GroznyiBombila/VichMashHW/README.md

# 4-битный сумматор на транзисторах 2N7000

Сумматор с последовательным переносом (ripple-carry) из 77 дискретных
полевых транзисторов, без единой микросхемы. Складывает два 4-битных числа
и входной перенос: A + B + Cin, результат от 0 до 31 горит на пяти светодиодах.

**[Схема в симуляторе Falstad](https://www.falstad.com/circuit/circuitjs.html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)**: открывается в браузере,
по переключателям можно щёлкать.

---

## Результаты работы

Папка работы: **[homework2](homework2/)**, фото: **[Results](homework2/Results/)**

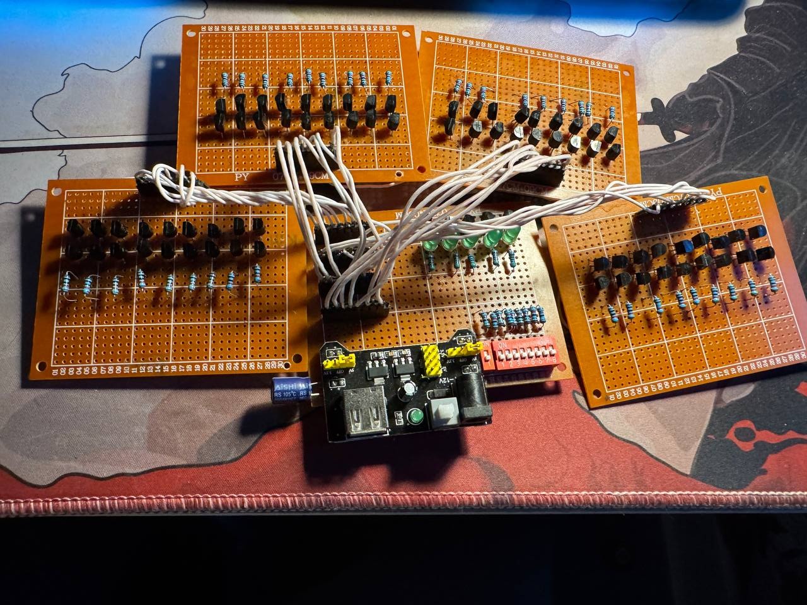
[picture p1: homework2/Results/device.jpg]
Устройство


Пять плат: четыре платы разряда (по одной на бит) и плата ввода-вывода с
переключателями и светодиодами. Питание 5 В от модуля MB102.

### Как читать

- Рычажки DIP-8 слева направо: B0 B1 B2 B3 A0 A1 A2 A3. Рычажок вверх (к ON) = 1.
- Отдельный красный DIP-1 слева = Cin.
- Светодиоды слева направо: Cout S3 S2 S1 S0, веса 16 8 4 2 1.

### Тесты

Разбор трёх тестов: какой рычажок за что отвечает и какие светодиоды горят.

<p>
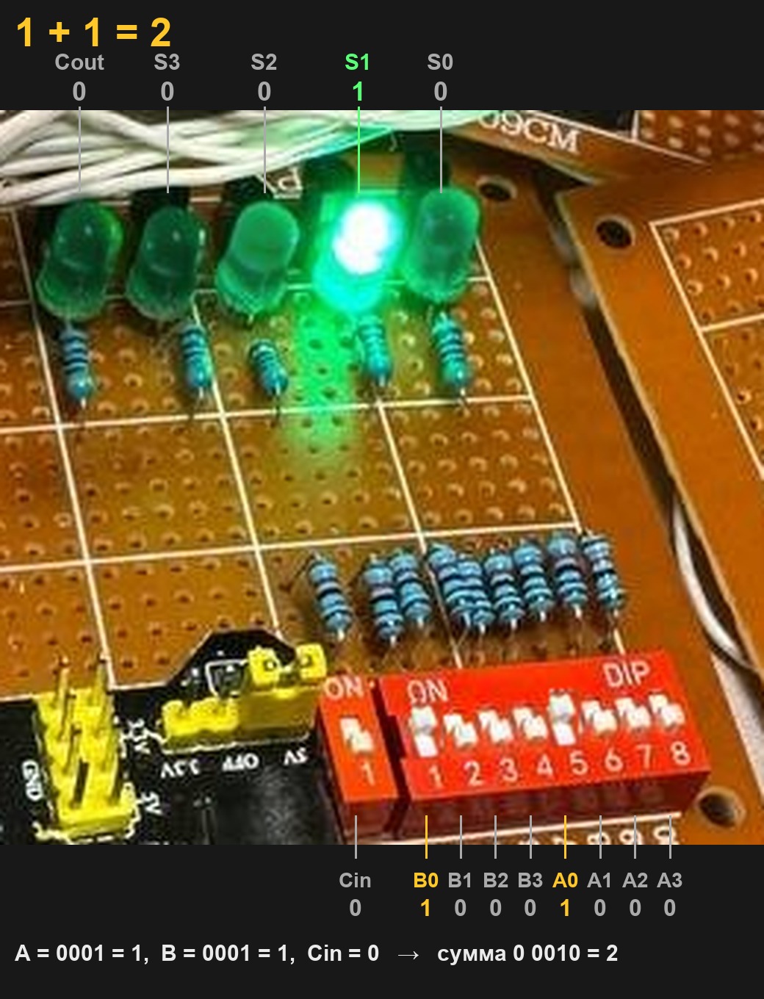
[picture p2: homework2/Results/test2_explained.jpg]
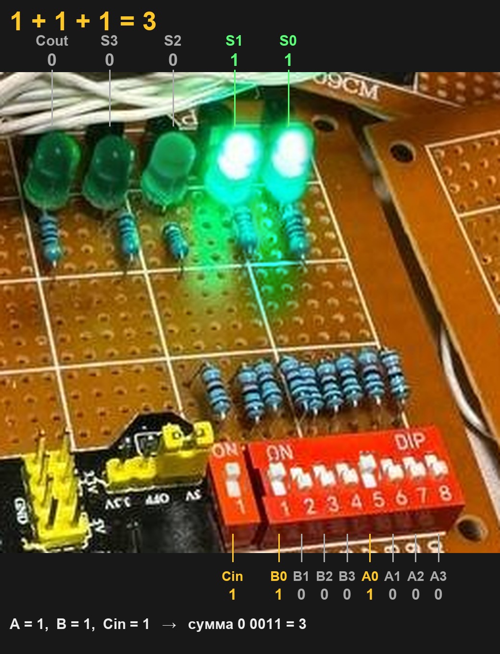
[picture p3: homework2/Results/test9_explained.jpg]
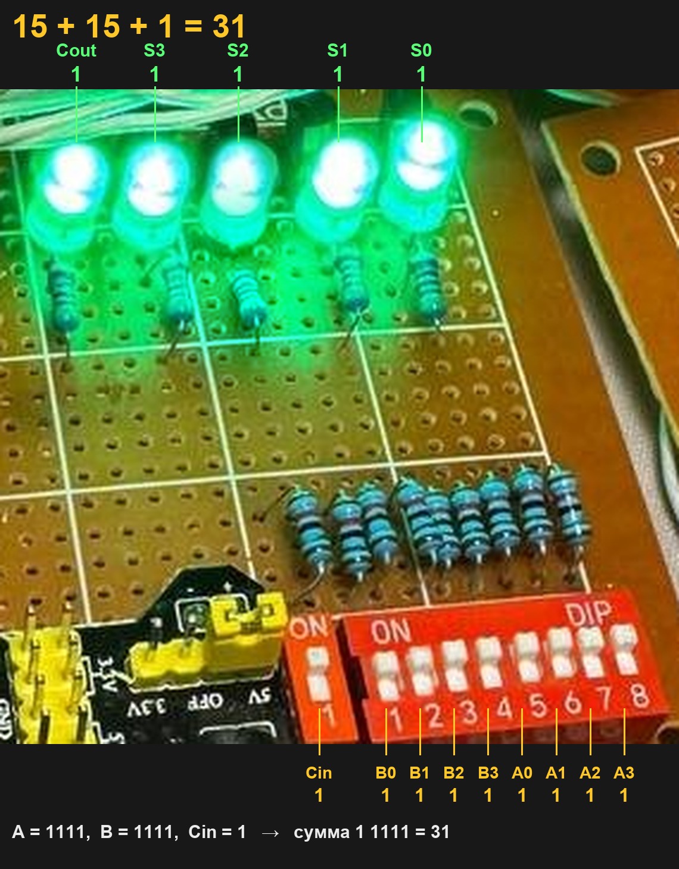
[picture p4: homework2/Results/test10_explained.jpg]
  
</p>

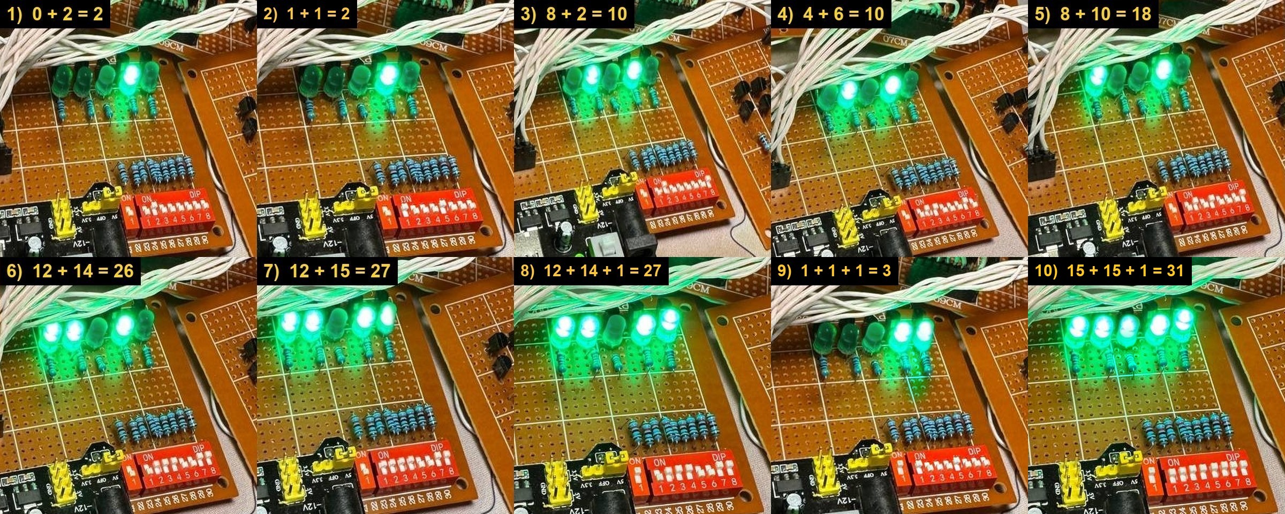
[picture p5: homework2/Results/tests.jpg]
Тесты


| № | A | B | Cin | сумма | светодиоды Cout S3 S2 S1 S0 | фото |
|---|---|---|---|---|---|---|
| 1 | 0000 (0) | 0010 (2) | 0 | 2 | 0 0010 | [test1](homework2/Results/test1.jpg) |
| 2 | 0001 (1) | 0001 (1) | 0 | 2 | 0 0010 | [test2](homework2/Results/test2.jpg), [крупно](homework2/Results/test2_close.jpg) |
| 3 | 1000 (8) | 0010 (2) | 0 | 10 | 0 1010 | [test3](homework2/Results/test3.jpg) |
| 4 | 0100 (4) | 0110 (6) | 0 | 10 | 0 1010 | [test4](homework2/Results/test4.jpg) |
| 5 | 1000 (8) | 1010 (10) | 0 | 18 | 1 0010 | [test5](homework2/Results/test5.jpg) |
| 6 | 1100 (12) | 1110 (14) | 0 | 26 | 1 1010 | [test6](homework2/Results/test6.jpg) |
| 7 | 1100 (12) | 1111 (15) | 0 | 27 | 1 1011 | [test7](homework2/Results/test7.jpg) |
| 8 | 1100 (12) | 1110 (14) | 1 | 27 | 1 1011 | [test8](homework2/Results/test8.jpg) |
| 9 | 0001 (1) | 0001 (1) | 1 | 3 | 0 0011 | [test9](homework2/Results/test9.jpg) |
| 10 | 1111 (15) | 1111 (15) | 1 | 31 | 1 1111 | [test10](homework2/Results/test10.jpg) |

- 1 + 1 = 2: в младшем разряде 1 + 1, сумма 0 и перенос в следующий разряд.
- 4 + 6 = 10: перенос из разряда 2 в разряд 3.
- 8 + 10 = 18: в старшем разряде 1 + 1, перенос уходит наружу и загорается Cout.
- Тесты 7 и 8 дают 27 двумя способами: единица в младшем разряде пришла
  от B0 или от входного переноса Cin.
- 1 + 1 + 1 = 3: в младшем разряде складываются все три входа, сумма 1 и перенос 1.
- 15 + 15 + 1 = 31: максимум, перенос проходит через все 4 разряда, горят все 5 светодиодов.

---

## Сборка и пайка

Все пять плат с компонентами, до соединения кабелями:

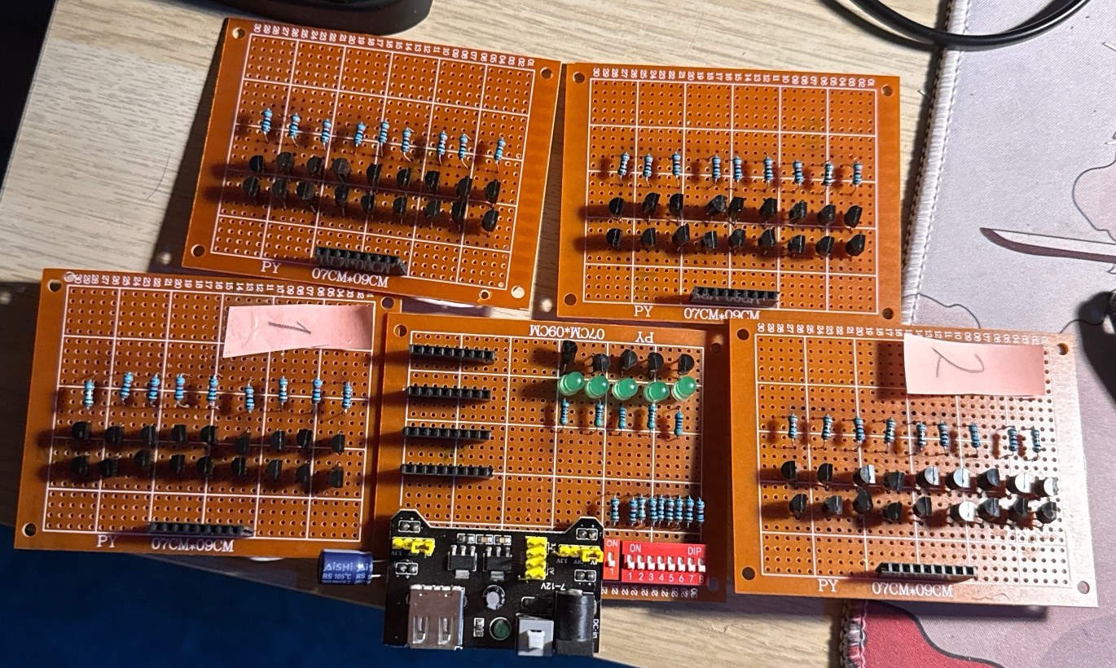
[picture p6: homework2/Results/assembly/boards_top.jpg]
Платы сверху


Плата ввода-вывода: сверху на этапе монтажа и снизу, готовая разводка.

<p>
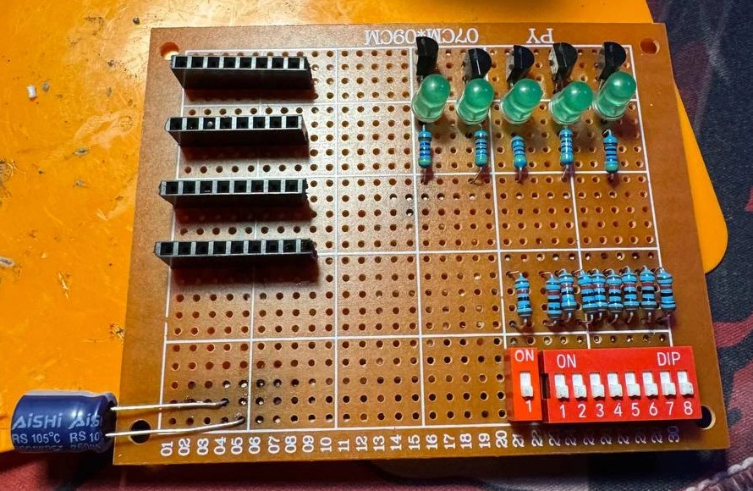
[picture p7: homework2/Results/assembly/io_board_top.jpg]
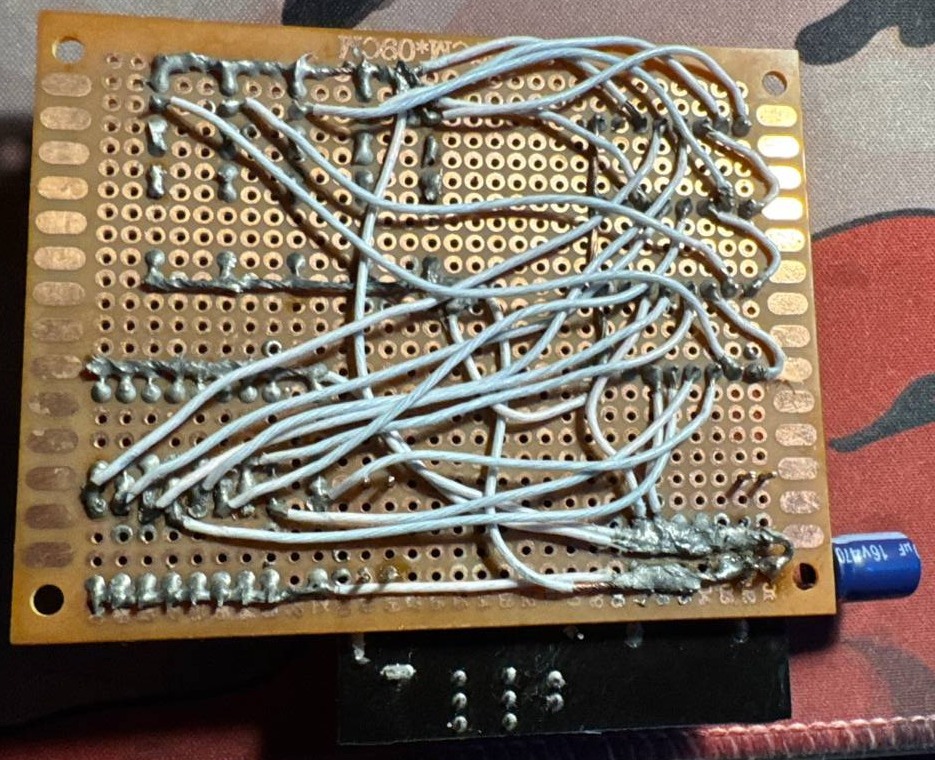
[picture p8: homework2/Results/assembly/io_board_bottom.jpg]
 
</p>

Плата разряда снизу: шина +5 В сверху, шина GND снизу, между ними перемычки
между ячейками и провода к разъёму.

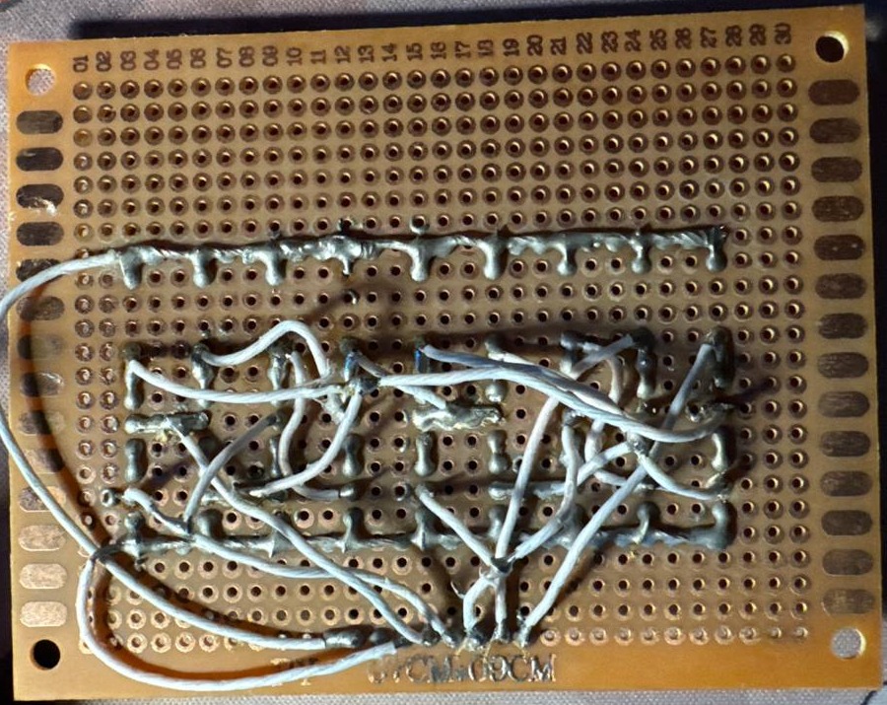
[picture p9: homework2/Results/assembly/bit_board_bottom.jpg]
Плата разряда снизу


Низ плат разряда и система в сборе, соединённая кабелями:

<p>
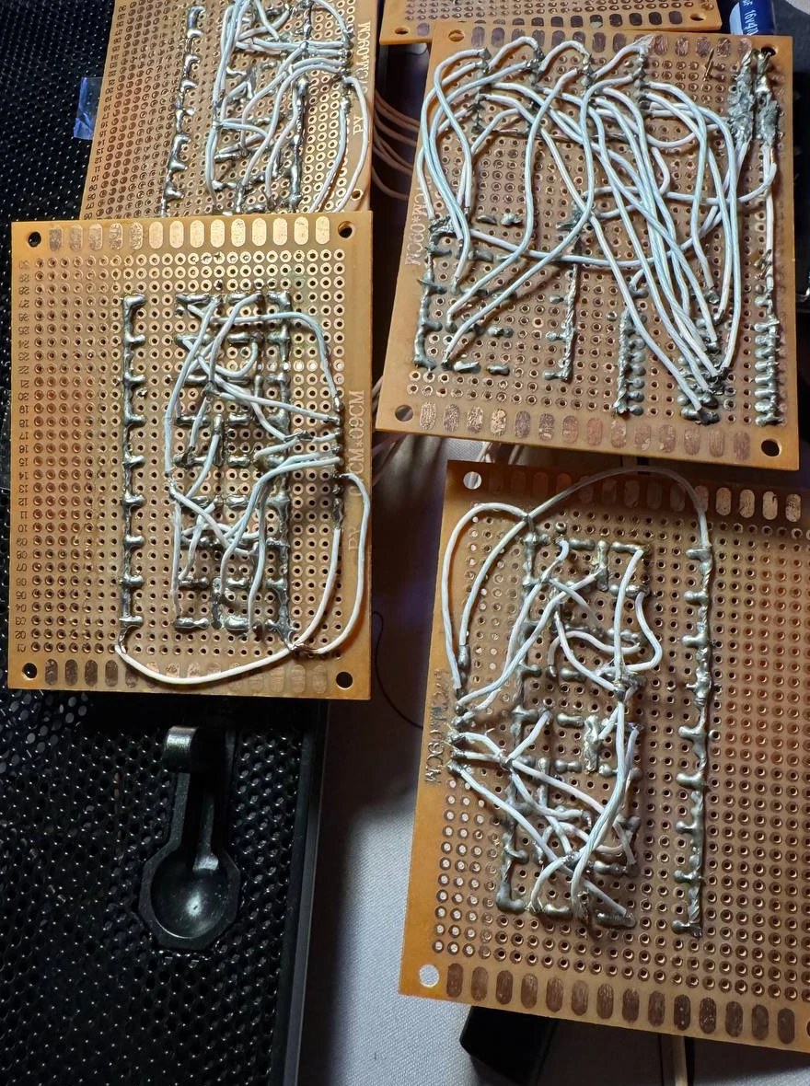
[picture p10: homework2/Results/assembly/boards_bottom.jpg]
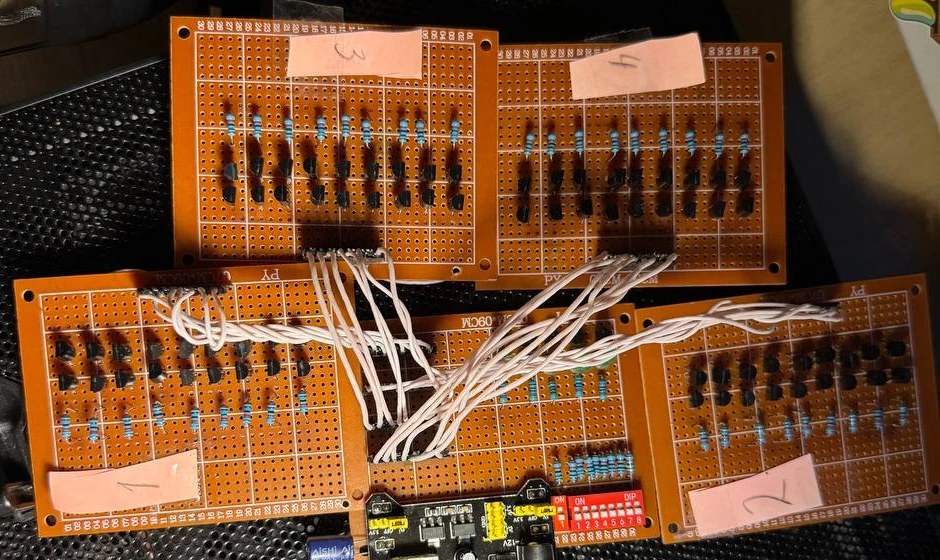
[picture p11: homework2/Results/assembly/system_wired.jpg]
 
</p>

---

## Как это работает

- **Вентиль И-НЕ**: два n-МОП транзистора последовательно и резистор 10 кОм к +5 В.
  Выход 0, только когда оба входа 1.
- **Полный сумматор** (один разряд): 9 вентилей И-НЕ, это 18 транзисторов и 9 резисторов.
  Складывает A, B, Cin и выдаёт сумму S и перенос Cout.
- **Перенос**: Cout разряда i идёт на Cin разряда i+1, как «1 в уме» при сложении
  столбиком. Перенос бежит от младшего разряда к старшему.

```
N1 = И-НЕ(A, B)      N4 = И-НЕ(N2, N3)  = A xor B
N2 = И-НЕ(A, N1)     N5 = И-НЕ(N4, Cin)
N3 = И-НЕ(B, N1)     N6 = И-НЕ(N4, N5)
                     N7 = И-НЕ(Cin, N5)
S    = И-НЕ(N6, N7)  = A xor B xor Cin
Cout = И-НЕ(N1, N5)  = A·B + Cin·(A xor B)
```

---

## Схемы

### Плата ввода-вывода и вся система

Рычажки через резисторы 10 кОм подают 0 или 5 В на входы, выходы разрядов
открывают транзисторы Q1–Q5, а те зажигают светодиоды. Четыре кабеля по
7 проводов идут к платам разряда.

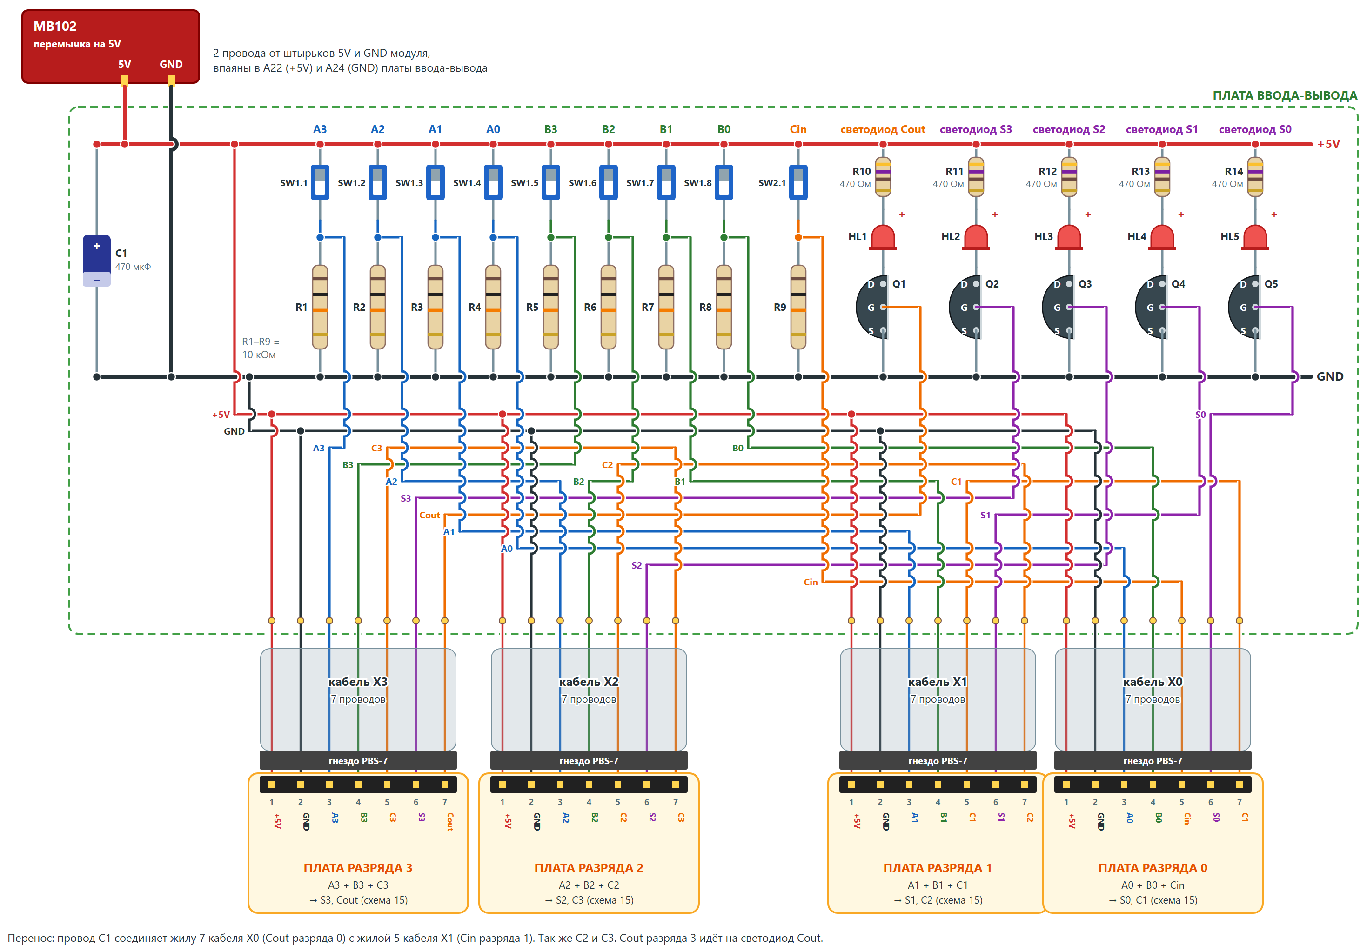
[picture p12: homework2/Results/io_board_and_system.png]
Плата ввода-вывода


### Плата разряда

Девять ячеек И-НЕ, разъём J1: +5V, GND, A, B, Cin, S, Cout.

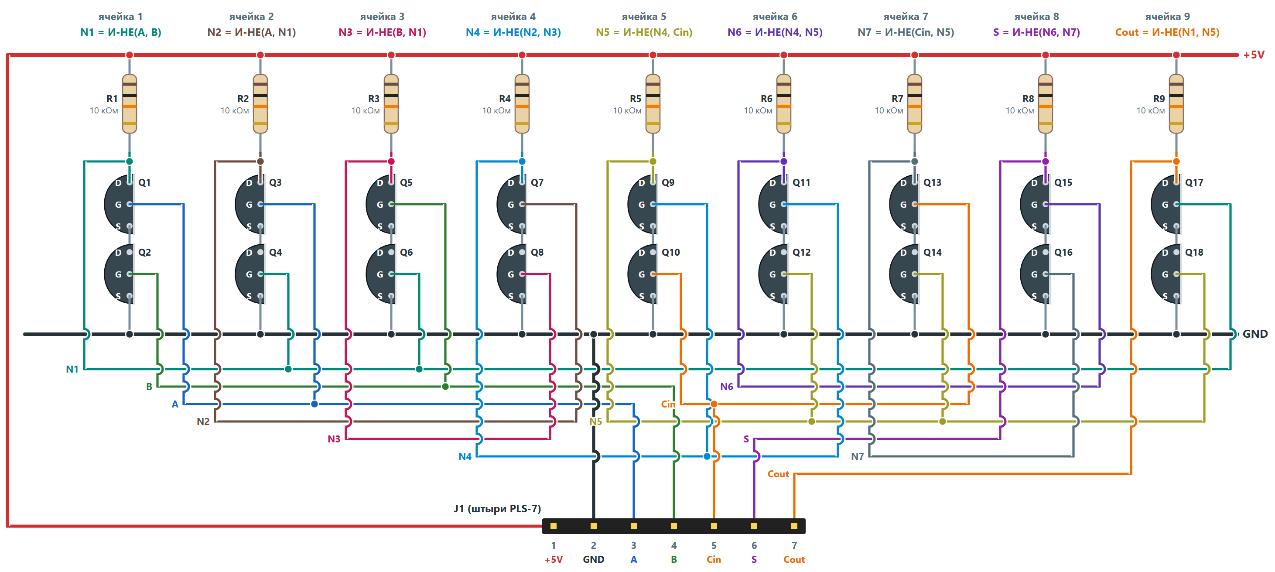
[picture p13: homework2/Results/bit_board.png]
Плата разряда


Остальные чертежи (расположение деталей по отверстиям, пайка снизу, цоколёвка):
[schematics/](homework2/schematics/), подробно в [assembly.md](homework2/assembly.md).

---

## Состав

| деталь | всего |
|---|---|
| транзистор 2N7000 | 77 (18 × 4 разряда + 5 на светодиоды) |
| резистор 10 кОм | 45 |
| резистор 470 Ом | 5 |
| светодиод 5 мм | 5 |
| DIP-переключатель на 8 и на 1 позицию | 1 + 1 |
| макетная плата 7×9 см | 5 |
| модуль питания MB102 | 1 |

```
homework2/Results/        фото устройства и основные схемы
schematics/     все чертежи (SVG)
sim/            схема для Falstad: ссылка и текст для импорта
tools/          генераторы чертежей и проверка раскладки на 512 комбинациях
assembly.md     сборка, проверка по шагам, таблица истинности разряда
wiring.md       список монтажа по отверстиям
```

---

## Как повторить

1. Открыть [схему в Falstad](https://www.falstad.com/circuit/circuitjs.html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) и проверить сложение в симуляторе.
   Тот же текст схемы лежит в [sim/adder4.txt](homework2/sim/adder4.txt) (Файл → Импорт из текста).
2. Собрать плату ввода-вывода и четыре платы разряда по [assembly.md](homework2/assembly.md)
   и [wiring.md](homework2/wiring.md).
3. Проверять разряды по одному, начиная с младшего, по таблице истинности из assembly.md.
