GroznyiBombila/VichMashHW/homework2/wiring.md

# Список монтажа

Сгенерировано скриптом `tools/boards.py` из тех же данных, что и чертежи, и проверено
моделированием всей собранной системы. Отверстие = буква ряда + номер столбца (вид сверху):
`F3` — ряд F, столбец 3. Отмечайте галочками по ходу пайки.

## Плата разряда (одинаковая для разрядов 0–3)

### Детали

- [ ] **R1** 10k: 1=A3, 2=E3
- [ ] **Q1** 2N7000: D=F3, G=G3, S=H3 (плоская сторона ВПРАВО, к столбцу 30; D сверху)
- [ ] **Q2** 2N7000: D=I3, G=J3, S=K3 (плоская сторона ВПРАВО, к столбцу 30; D сверху)
- [ ] **R2** 10k: 1=A6, 2=E6
- [ ] **Q3** 2N7000: D=F6, G=G6, S=H6 (плоская сторона ВПРАВО, к столбцу 30; D сверху)
- [ ] **Q4** 2N7000: D=I6, G=J6, S=K6 (плоская сторона ВПРАВО, к столбцу 30; D сверху)
- [ ] **R3** 10k: 1=A9, 2=E9
- [ ] **Q5** 2N7000: D=F9, G=G9, S=H9 (плоская сторона ВПРАВО, к столбцу 30; D сверху)
- [ ] **Q6** 2N7000: D=I9, G=J9, S=K9 (плоская сторона ВПРАВО, к столбцу 30; D сверху)
- [ ] **R4** 10k: 1=A12, 2=E12
- [ ] **Q7** 2N7000: D=F12, G=G12, S=H12 (плоская сторона ВПРАВО, к столбцу 30; D сверху)
- [ ] **Q8** 2N7000: D=I12, G=J12, S=K12 (плоская сторона ВПРАВО, к столбцу 30; D сверху)
- [ ] **R5** 10k: 1=A15, 2=E15
- [ ] **Q9** 2N7000: D=F15, G=G15, S=H15 (плоская сторона ВПРАВО, к столбцу 30; D сверху)
- [ ] **Q10** 2N7000: D=I15, G=J15, S=K15 (плоская сторона ВПРАВО, к столбцу 30; D сверху)
- [ ] **R6** 10k: 1=A18, 2=E18
- [ ] **Q11** 2N7000: D=F18, G=G18, S=H18 (плоская сторона ВПРАВО, к столбцу 30; D сверху)
- [ ] **Q12** 2N7000: D=I18, G=J18, S=K18 (плоская сторона ВПРАВО, к столбцу 30; D сверху)
- [ ] **R7** 10k: 1=A21, 2=E21
- [ ] **Q13** 2N7000: D=F21, G=G21, S=H21 (плоская сторона ВПРАВО, к столбцу 30; D сверху)
- [ ] **Q14** 2N7000: D=I21, G=J21, S=K21 (плоская сторона ВПРАВО, к столбцу 30; D сверху)
- [ ] **R8** 10k: 1=A24, 2=E24
- [ ] **Q15** 2N7000: D=F24, G=G24, S=H24 (плоская сторона ВПРАВО, к столбцу 30; D сверху)
- [ ] **Q16** 2N7000: D=I24, G=J24, S=K24 (плоская сторона ВПРАВО, к столбцу 30; D сверху)
- [ ] **R9** 10k: 1=A27, 2=E27
- [ ] **Q17** 2N7000: D=F27, G=G27, S=H27 (плоская сторона ВПРАВО, к столбцу 30; D сверху)
- [ ] **Q18** 2N7000: D=I27, G=J27, S=K27 (плоская сторона ВПРАВО, к столбцу 30; D сверху)
- [ ] **J1** PLS-7: 1=O12, 2=O13, 3=O14, 4=O15, 5=O16, 6=O17, 7=O18

### Шины (голый лужёный провод снизу; припаять к каждому выводу детали, который на него попадает, и по концам)

- [ ] +5V: A1 → A29
- [ ] GND: L1 → L29

### Соединения соседних отверстий снизу (69 шт.): загнуть ножку на соседнюю площадку и спаять

- [ ] E3–F3, H3–I3, K3–L3, G2–G3, J2–J3, F4–F3, E6–F6, H6–I6
- [ ] K6–L6, G5–G6, J5–J6, F7–F6, E9–F9, H9–I9, K9–L9, G8–G9
- [ ] J8–J9, F10–F9, E12–F12, H12–I12, K12–L12, G11–G12, J11–J12, F13–F12
- [ ] E15–F15, H15–I15, K15–L15, G14–G15, J14–J15, F16–F15, E18–F18, H18–I18
- [ ] K18–L18, G17–G18, J17–J18, F19–F18, E21–F21, H21–I21, K21–L21, G20–G21
- [ ] J20–J21, F22–F21, E24–F24, H24–I24, K24–L24, G23–G24, J23–J24, F25–F24
- [ ] E27–F27, H27–I27, K27–L27, G26–G27, J26–J27, F28–F27, F4–E4, E4–D4
- [ ] F13–E13, F16–E16, E16–D16, O12–N12, O13–N13, O14–N14, O14–P14, O15–N15
- [ ] O15–P15, O16–N16, O16–P16, O17–N17, O18–N18

### Провода сверху (22 шт.)

| # | цепь | откуда | куда |
|---|---|---|---|
| 1 | +5V | N12 | A10 |
| 2 | GND | N13 | L13 |
| 3 | A | N14 | G2 |
| 4 | B | N15 | J2 |
| 5 | A | P14 | G5 |
| 6 | N1 | F4 | J5 |
| 7 | B | P15 | G8 |
| 8 | N1 | E4 | J8 |
| 9 | N2 | F7 | G11 |
| 10 | N3 | F10 | J11 |
| 11 | N4 | F13 | G14 |
| 12 | Cin | N16 | J14 |
| 13 | N4 | E13 | G17 |
| 14 | N5 | F16 | J17 |
| 15 | Cin | P16 | G20 |
| 16 | N5 | E16 | J20 |
| 17 | N6 | F19 | G23 |
| 18 | N7 | F22 | J23 |
| 19 | N1 | D4 | G26 |
| 20 | N5 | D16 | J26 |
| 21 | S | F25 | N17 |
| 22 | Cout | F28 | N18 |

## Плата ввода-вывода

### Детали

- [ ] **J1** PLS-3: 1=A22, 2=A23, 3=A24
- [ ] **C1** 470 мкФ: +=G22, -=G24 (полоса «−» на корпусе к GND)
- [ ] **SW1** DIP-8: верхний ряд выводов C2…C9, нижний F2…F9
- [ ] **SW2** DIP-1: выводы C12 и F12
- [ ] **R1** 10k: 1=H2, 2=L2
- [ ] **R2** 10k: 1=H3, 2=L3
- [ ] **R3** 10k: 1=H4, 2=L4
- [ ] **R4** 10k: 1=H5, 2=L5
- [ ] **R5** 10k: 1=H6, 2=L6
- [ ] **R6** 10k: 1=H7, 2=L7
- [ ] **R7** 10k: 1=H8, 2=L8
- [ ] **R8** 10k: 1=H9, 2=L9
- [ ] **R9** 10k: 1=H12, 2=L12
- [ ] **R10** 470: 1=N3, 2=R3
- [ ] **HL1** LED: A=S3, K=T3 (длинная ножка, анод, в A)
- [ ] **Q1** 2N7000: D=U3, G=V3, S=W3 (плоская сторона ВПРАВО, к столбцу 30; D сверху)
- [ ] **R11** 470: 1=N7, 2=R7
- [ ] **HL2** LED: A=S7, K=T7 (длинная ножка, анод, в A)
- [ ] **Q2** 2N7000: D=U7, G=V7, S=W7 (плоская сторона ВПРАВО, к столбцу 30; D сверху)
- [ ] **R12** 470: 1=N11, 2=R11
- [ ] **HL3** LED: A=S11, K=T11 (длинная ножка, анод, в A)
- [ ] **Q3** 2N7000: D=U11, G=V11, S=W11 (плоская сторона ВПРАВО, к столбцу 30; D сверху)
- [ ] **R13** 470: 1=N15, 2=R15
- [ ] **HL4** LED: A=S15, K=T15 (длинная ножка, анод, в A)
- [ ] **Q4** 2N7000: D=U15, G=V15, S=W15 (плоская сторона ВПРАВО, к столбцу 30; D сверху)
- [ ] **R14** 470: 1=N19, 2=R19
- [ ] **HL5** LED: A=S19, K=T19 (длинная ножка, анод, в A)
- [ ] **Q5** 2N7000: D=U19, G=V19, S=W19 (плоская сторона ВПРАВО, к столбцу 30; D сверху)

### Шины (голый лужёный провод снизу; припаять к каждому выводу детали, который на него попадает, и по концам)

- [ ] +5V: A22 → T22
- [ ] GND: A24 → X24
- [ ] +5V: C1 → C22
- [ ] GND: L1 → L20
- [ ] +5V: N1 → N22
- [ ] GND: X1 → X24

### Соединения соседних отверстий снизу (58 шт.): загнуть ножку на соседнюю площадку и спаять

- [ ] F2–G2, G2–H2, F3–G3, G3–H3, F4–G4, G4–H4, F5–G5, G5–H5
- [ ] F6–G6, G6–H6, F7–G7, G7–H7, F8–G8, G8–H8, F9–G9, G9–H9
- [ ] F12–G12, G12–H12, R3–S3, T3–U3, W3–X3, V2–V3, R7–S7, T7–U7
- [ ] W7–X7, V6–V7, R11–S11, T11–U11, W11–X11, V10–V11, R15–S15, T15–U15
- [ ] W15–X15, V14–V15, R19–S19, T19–U19, W19–X19, V18–V19, K25–L25, K26–L26
- [ ] K27–L27, K28–L28, K29–L29, N25–O25, N26–O26, N27–O27, N28–O28, N29–O29
- [ ] Q25–R25, Q26–R26, Q27–R27, Q28–R28, Q29–R29, T25–U25, T26–U26, T27–U27
- [ ] T28–U28, T29–U29

### Провода сверху (18 шт.)

| # | цепь | откуда | куда |
|---|---|---|---|
| 1 | GND | L20 | L24 |
| 2 | A0 | G5 | L25 |
| 3 | B0 | G9 | L26 |
| 4 | S0 | L28 | V18 |
| 5 | A1 | G4 | O25 |
| 6 | B1 | G8 | O26 |
| 7 | S1 | O28 | V14 |
| 8 | A2 | G3 | R25 |
| 9 | B2 | G7 | R26 |
| 10 | S2 | R28 | V10 |
| 11 | A3 | G2 | U25 |
| 12 | B3 | G6 | U26 |
| 13 | S3 | U28 | V6 |
| 14 | Cin | G12 | L27 |
| 15 | C1 | L29 | O27 |
| 16 | C2 | O29 | R27 |
| 17 | C3 | R29 | U27 |
| 18 | Cout | U29 | V2 |

### Кабели к платам разрядов

Каждый кабель — 7 проводов длиной 15–20 см. Один конец впаивается в плату ввода-вывода,
на другой напаивается гнездо PBS-7 (контакт 1 = +5V), которое надевается на J1 платы разряда.

| кабель | 1 | 2 | 3 | 4 | 5 | 6 | 7 |
|---|---|---|---|---|---|---|---|
| X0 → разряд 0 | +5V (K22) | GND (K24) | A0 (K25) | B0 (K26) | Cin (K27) | S0 (K28) | C1 (K29) |
| X1 → разряд 1 | +5V (N22) | GND (N24) | A1 (N25) | B1 (N26) | C1 (N27) | S1 (N28) | C2 (N29) |
| X2 → разряд 2 | +5V (Q22) | GND (Q24) | A2 (Q25) | B2 (Q26) | C2 (Q27) | S2 (Q28) | C3 (Q29) |
| X3 → разряд 3 | +5V (T22) | GND (T24) | A3 (T25) | B3 (T26) | C3 (T27) | S3 (T28) | Cout (T29) |
