GroznyiBombila/VichMashHW/homework2/Results/assembly/bit_board_bottom_2.jpg

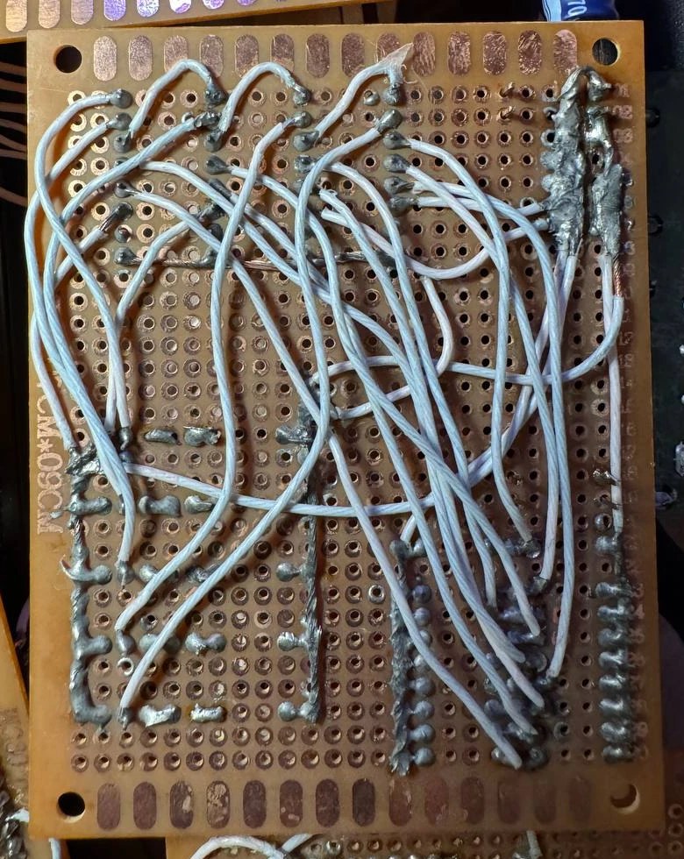
homework2/Results/assembly/bit_board_bottom_2.jpg
