GroznyiBombila/VichMashHW/homework2/Results/summary.csv

тест | nano_мкс | nano_тактов | yotik_мкс | yotik_тактов | esp32cam_мкс | esp32cam_тактов
op_empty | 29416 | 23.53 | 674 | 8.09 | 675 | 8.1
op_add8 | 37876 | 30.3 | 1424 | 17.09 | 1424 | 17.09
op_add32 | 44160 | 35.33 | 1092 | 13.11 | 1093 | 13.12
op_mul32 | 130928 | 104.74 | 1088 | 13.07 | 1088 | 13.07
op_div32 | 806180 | 644.94 | 1339 | 16.07 | 1339 | 16.07
op_addf | 188776 | 151.02 | 1090 | 13.08 | 1090 | 13.08
op_mulf | 226496 | 181.2 | 1089 | 13.07 | 1088 | 13.07
op_divf | 637684 | 510.15 | 5020 | 60.25 | 5020 | 60.25
op_muld | 226484 | 181.19 | 10706 | 128.47 | 10707 | 128.48
call_flat | 63020 | 50.42 | 2850 | 34.2 | 2848 | 34.17
call_deep | 32564 | 26.05 | 4932 | 59.17 | 4930 | 59.16
mandel_float | 817700 | 17035.42 | 1620 | 506.25 | 1618 | 505.62
mandel_fixed | 168856 | 3517.83 | 1119 | 349.69 | 1118 | 349.37
mem_sram_step1 | 1888008 | 15.1 | 76480 | 9.03 | 80086 | 9.46
mem_sram_step2 | 944572 | 15.11 | 38239 | 9.03 | 41608 | 9.83
mem_sram_step4 | 472816 | 15.12 | 19122 | 9.04 | 20793 | 9.83
mem_sram_step8 | 236928 | 15.16 | 9562 | 9.04 | 10423 | 9.85
mem_sram_step16 | 119004 | 15.23 | 4782 | 9.04 | 5214 | 9.86
mem_sram_step32 | 60032 | 15.36 | 2393 | 9.05 | 2607 | 9.86
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
