GroznyiBombila/VichMashHW/homework1/Results/vich1.png

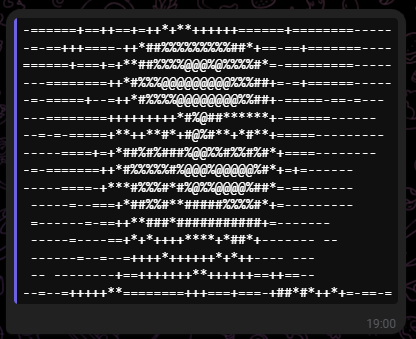
homework1/Results/vich1.png
