GroznyiBombila/VichMashHW/homework1/Results/vich2.png

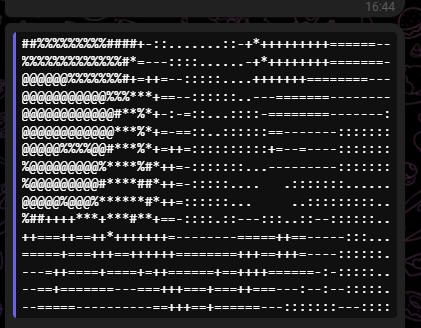
homework1/Results/vich2.png
