GroznyiBombila/VichMashHW/homework1/Results/vich3.png

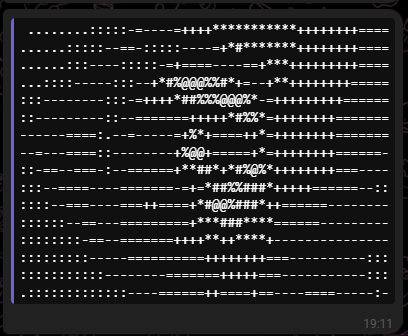
homework1/Results/vich3.png
