GroznyiBombila/VichMashHW/homework1/Results/vich4.png

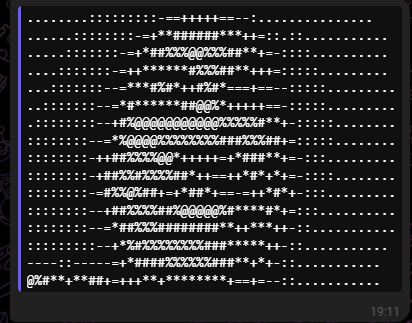
homework1/Results/vich4.png
