GroznyiBombila/VichMashHW/homework1/Results/vich5.png

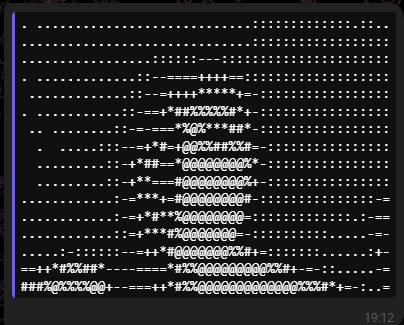
homework1/Results/vich5.png
