GroznyiBombila/VichMashHW/homework1/Results/vich6.png

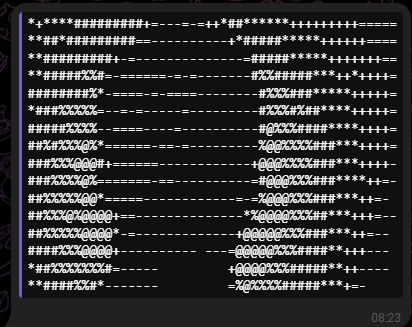
homework1/Results/vich6.png
