GroznyiBombila/VichMashHW/homework1/Results/vich7.png

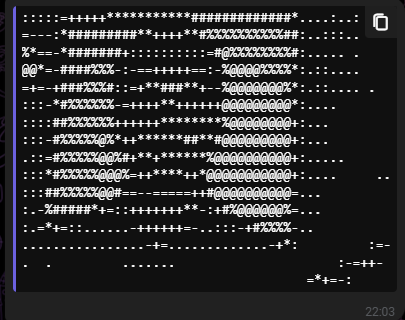
homework1/Results/vich7.png
