GroznyiBombila/VichMashHW/homework2/Results/chart_freq.png

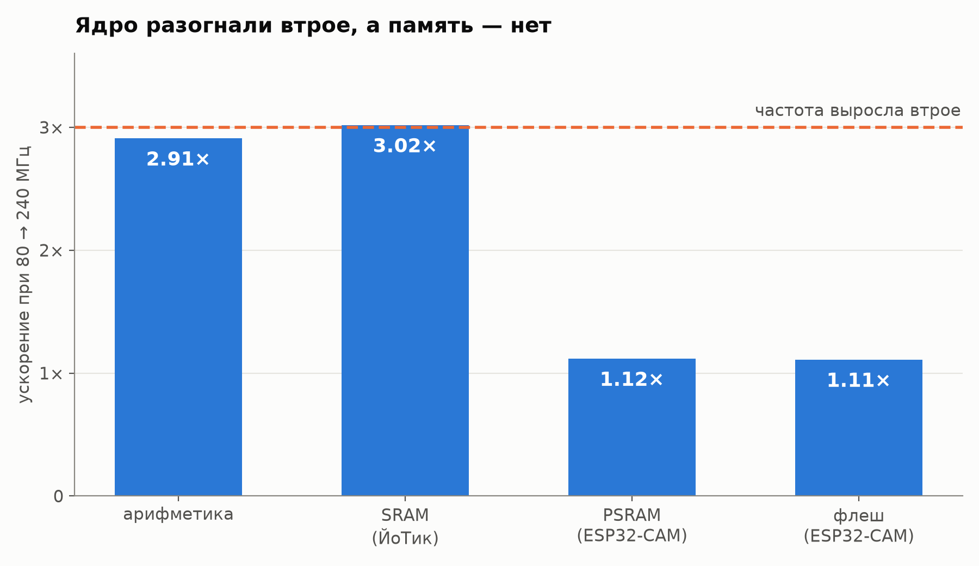
homework2/Results/chart_freq.png
