GroznyiBombila/VichMashHW/homework2/Results/chart_memory.png

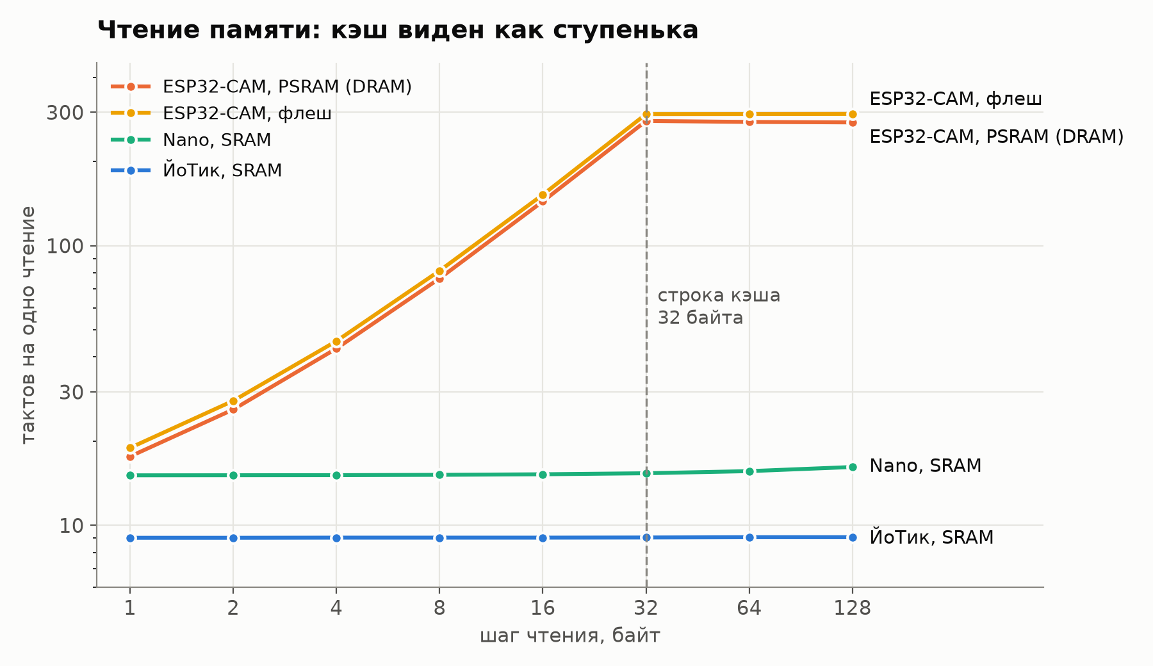
homework2/Results/chart_memory.png
