GroznyiBombila/VichMashHW/homework2/Results/chart_ratio.png

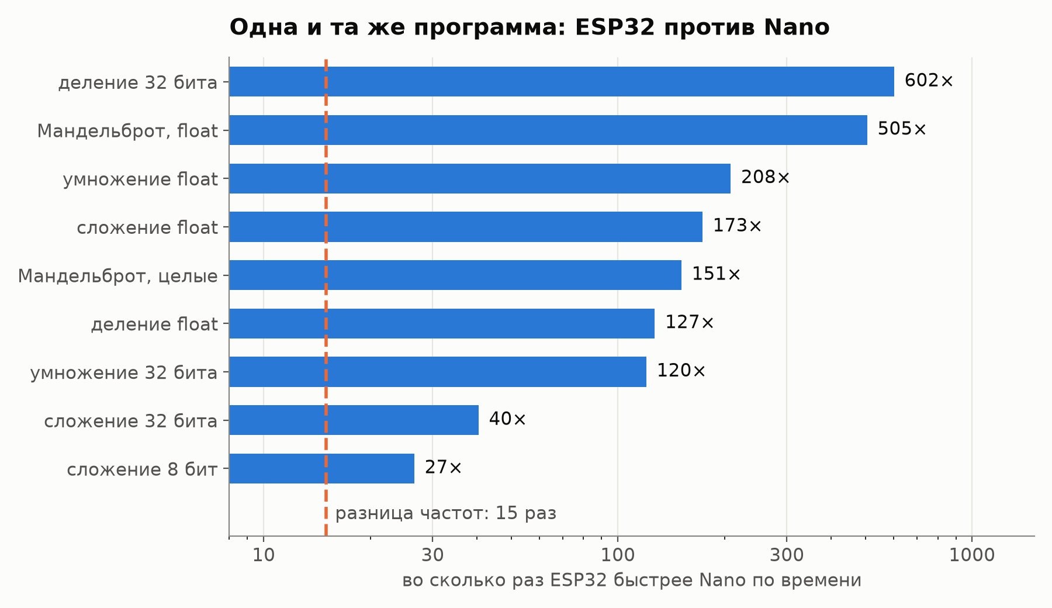
homework2/Results/chart_ratio.png
