GroznyiBombila/VichMashHW/homework2/Results/test2_close.jpg

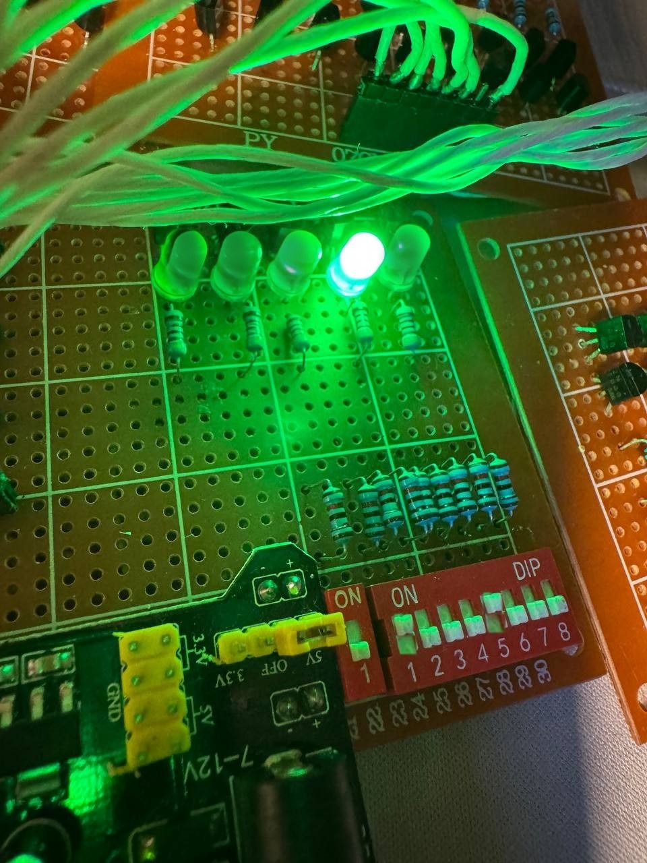
homework2/Results/test2_close.jpg
