GroznyiBombila/VichMashHW/(commit log)

2026-09-16 ESP32-CAM: OLED-превью, псевдографика в Telegram, диагностика и перенаправитель на VPS
2026-09-17 Результаты работы: скриншоты и новый README
2026-09-17 Код перенесён в папку code
2026-09-27 ДЗ 2: одна программа на трёх процессорах — скетч, замеры, графики
    [summary.csv]
2026-09-27 ДЗ 1 перенесено в папку homework1, в README добавлена ссылка на ДЗ 2
2026-09-27 В основном README только ДЗ 2, описание ДЗ 1 перенесено в homework1/README.md
2026-10-14 Старое ДЗ 2 (три процессора) убрано из репозитория
2026-10-14 ДЗ 2: 4-битный сумматор на 2N7000 — фото, схемы плат, ссылка на симулятор Falstad
2026-10-14 ДЗ 2: 8 тестов сложения на фото
2026-10-14 ДЗ 2: подпись на сетке тестов
2026-10-14 ДЗ 2: тест 1 + 1 = 2 в общем ракурсе и разбор с подписями
2026-10-14 ДЗ 2: тесты 1 + 1 + 1 = 3 и 15 + 15 + 1 = 31
2026-10-14 ДЗ 2: отсвет светодиодов на тестах 9 и 10
2026-10-14 ДЗ 2: фото пайки и сборки, подписи на фото убраны
2026-10-14 homework2: фото каждого теста отдельно в README вместо коллажа
2026-10-14 homework2: новые чёткие фото устройства и плат снизу
2026-10-14 homework2: фото устройства и платы ввода-вывода горизонтально
